Mark-Nielsen/2.-Semesters-projekt/README.md

# 2. Semesterprojekt

**Læs hele rapporten her:** [2. semesterprojekt rapport.pdf](<./2. semesterprojekt rapport.pdf>)
