Mark-Nielsen/2.-Semesters-projekt/Filer bruger under udvikling/1. Projekt/Bilag 1.A - Analyse.docx

# 1 Analyse

## 1.1 Hardware analyse

### 1.1.1 Infrarød sensor

Efter at have besluttet, at der i gruppen skulle bruges en infrarød sensor, blev der kigget efter hvilke sensorer der findes, og var mulige at få fat i. I denne forbindelse blev der kigget meget på hjemmesiden for elektronikværkstedet for at få inspiration. På vejen til det endelige valg af infrarød sensor, blev der forsøgt med forskellige slags.

Infrarød linetracker sensor KY-033

Den første infrarødsensor der blev brugt, var en Infrarød linetracker sensor KY-033, men efter nærmere undersøgelse i databladet blev der fundet ud af, at den ikke kunne opfylde de krav, der var til den infrarøde sensor, idet denne sensor kunne registrere hvorvidt den var på en specifik linje. Derfor var der nødvendighed for at fravælge denne sensor.

MH-SR602 PIR sensor

Dernæst blev infrarøde sensorer MH-SR602 PIR testet for anvendelse. De kunne registrere bevægelse og brugte infrarød stråling. Forståelse af hvordan sensoren virkede var, at den brugte infrarød stråling samt registrerede bevægelse til at detektere, hvorvidt en person var til stede i et givent rum. Dog efter at have testet disse med Arduino, blev det opdaget, at sensoren i stedet returnerede, hvorvidt der var bevægelse i et rum eller ej, og brugte den infrarøde stråling til at vurdere dette. Der blev derudover konkluderet, at den var meget upræcis i forhold til små ændringer i bevægelse, som den ikke kunne detektere, og dermed ville den ikke kunne detektere fx åndedræt fra patienter. Dermed opstod et problem, idet det var tiltænkt, at sensoren netop skulle kunne detektere ved brug af infrarød stråling om der var personer i et rum eller ej. Dog var sensoren nem at sætte op og bruge med en Arduino, og det blev hurtigt tydeliggjort, at den virkede som den skulle, dog ikke helt som ønsket i forhold til projektets mål. På trods af dette, var denne sensor stadig med i overvejelsen, idet der var 3 af disse sensorer til rådighed, hvilket ville betyde at der som ønsket kunne være en sensor i hver af de 3 rum, som brug til test af hvorvidt systemet virker.

Time of Flight VL53L0X sensor

Dernæst blev der undersøgt igen, hvilke infrarøde sensorer, der ville kunne bruges og efter samtale og vejledning fra en underviser fra projektfaget, blev der anbefalet at kigge på en Time of Flight sensor. Denne sensor brugte nemlig ikke meget strøm og brugte lysfotoner, som den udsendte i en lige linje, hvorefter tiden der gik fra at lysfotonerne blev udsendt og modtaget i sensoren igen, afgøre både afstand men også om der var et objekt.

Efter nærmere undersøgelse af hvordan disse virkede, blev der vurderet at det var et forsøg værd at teste denne Time of Flight sensor for at se, hvordan den virkede. Dog efter at kigge på elektronikværkstedets lager, var der ikke nok til at låne 3 stk. til systemet der skulle bygges. Dermed begyndte diskussionen på, hvorvidt der skulle købes nogle nye sensorer hjem, som desuden var af nyeste version og måske ville virke endnu bedre end dem fra elektronikværkstedet. Dog ville leveringen af disse tage tid, hvor der altså ikke kunne arbejdes på det, og da der begyndte at blive mindre og mindre tid tilbage, var der tvivl om denne sensor ville være det bedste valg.

Alligevel, valgtes at prøve at anvende en VL53L0X med en Arduino og bruge et stykke test-kode, fundet fra nettet. Resultat var ikke som forventet, idet at det så ud til at Arduinoen modtog signaler fra 2 forskellige sensorer på trods af, at der kun var koblet 1 sensor til. Der blev brugt en I2C protokol i denne test af sensoren, og der kunne ses på Arduino’en at de to adresser, den modtog signaler fra, ikke var fra adressen på den tilkoblede sensor. Dog var der også tydelige tegn på brug af sensoren, blev der antaget at den burde virke, men det virkede ikke til at være tilfældet. Derudover blev der fundet ud af, at denne sensor kun kan måle i én lige linje og vil derfor ikke kunne måle et helt rum. Dermed blev der overvejet at hvis sensoren virkede, så ville den blot blive placeret over fx sengene i hvert rum på et hospital, da det ville være her en patient kunne ligge i respirator og dermed ville blive opdaget af sensoren, i modsætning til en bevægelsessensor.

Efter at have brugt lang tid på at forsøge at få det til at virke med en Arduino, måtte denne løsning opgives, idet det blev for tidskrævende.

Overvejelser omkring MH-SR602 PIR sensor vs. Thermal camera vs. Tredje option

Inde på guiden som var tilgængelig på elektronikværkstedets webside, står der således omkring det termiske kamera i forhold til Arduino’en: ”If using an Arduino-compatible, you'll need a processor with at least 20KB RAM - a SAMD21 (M0) or SAMD51 (M4) chipset will do nicely”

Til forståelse af sensorens leveret output og outputtets form, bruges Gemini. Efter at have læst mere om sensorerne, vurderes det, at arbejdet med de termiske kameraer ville være en del tidskrævende, idet man skal sætte sig ind i både matriceregning og ADC og I2C kommunikation. Dog er I2C kommunikation brugbart og smart at bruge da man kan bruge forskellige enheder på samme tid og der skal desuden bruges færre ledninger.

Det termiske kamera er en løsning, der øger præcisionen af sensor løsningen. Dog kan det være svært at kode at den også skal tage højde for, at en person kan ligge under en dyne, da tanken umiddelbart var at den skulle kunne vurdere om der var en person til stede ud fra selvfølgelig temperaturen af pxiels’ene samt hvor mange pixels, der har denne temperatur - for at vise om det bare er et objekt eller en faktisk person. Derudover er databladet på 60 sider, hvor en stor del af det indeholder, hvad der ligner, komplicerede beregninger, som kræver en del tid at sætte sig ind i og forstå. Efter vejledning fra GAI (Gemini), kan der desuden konkluderes, at Arduinoen anvendt havde en clockfrekvens, der var for lav til at det ville give mening at bruge disse sensorer.

Hi-Link LD2450 Microwave Radar Module

Som en tredje mulighed kigges på Hi-Link LD2450 Microwave Radar Module, da denne bruger radar (doppler effekt) hvilket var mere præcist i forhold til PIR Sensor Module. Tanken var, at denne sensor muligvis kunne detektere så præcist at den kunne opfange et menneskes åndedræt. For at undersøge om denne sensor kunne bruges, blev der kigget på sensorernes datablad for at se dens egenskaber og begrænsninger, herunder fx max supply voltage. Derudover har der været forsøg på at opnå en forståelse for et stykke kode fra databladet, som kan bruges til denne sensor for at forstå, hvordan den virker. Ud fra dette blev der fundet ud af, at man kan indstille på nogle forskellige parametre, som er relevante for projektet, eksempelvis hvor hurtigt den kan detektere aktivitet i cm/s. Generelt, virker denne sensor til at være mere simpel at implementere. Denne sensor blev testet med Arduinoen og et stykke kode, for at se hvordan den reelt set virker og om den egentlig virker.

Der var en udfordring med at Arduino ikke modtog noget signal fra sensoren. Dette ledte til en større tidskrævende proces med debugging, hvor der blev testet både om sensoren overhovedet fik nok strøm hvortil der blev brugt et multimeter, og der blev testet om ledningerne virkede, da var nødvendighed for at gå med en mere hjemmelavet løsning, da Harwin husene ikke passede på de pins, der var på sensoren. der blev derudover også søgt om hjælp fra Gemini, som anbefalede at der blev brugt en spændingsdeler, som halvt blev forsøgte at forstå selv, og halvt blev forstået ved hjælp af elektronikværkstedet for at få vejledning.

Signalerne der kom ind, var hextal, og for denne specifikke sensor skulle det første sæt af hextal bestå af AA FF 03 00, hvorefter de efterfølgende hextal ville være output signalet fra sensoren. Dette var noget der kunne findes i databladet. Problemet var dog at man ikke kunne få denne sekvens af hextal frem på trods af mange timers debugging. Det tætteste man kunne komme frem til, var 00 FE 03 00. Efter at have fået hjælp og vejledning fra GAI samt eksperimenteret med ændring i testkode og opsætning af hardware, blev der konkluderet, at det var baudraten der var problemer med. Denne sensor havde nemlig en default baudrate på 256000, hvorimod Arduinoen stod på 9600 eller 115200. Der blev derfor forsøgt at øge baudraten på Arduinoen, hvilket gjorde at resultatet kom tættere på det rigtige sæt af hextal, dog var det ikke nok. Efter en omskrivning af koden, lykkedes det at omdanne disse hextal til mål af afstand i mm. Dog var målingerne meget ustabile og upræcise. Derfor blev der diskuteret hvorvidt målingerne var brugbare og om sensoren kunne bruges til projektet. Argumenter for at bruge sensoren var at den var mere kompleks og derfor måske mere spændende at arbejde med og samtidig var den stadig mere præcis end den oprindelige planlagte PIR sensorer, idet den kunne måle præcis afstand fremfor et output signal på HIGH eller LOW ved detekteret bevægelse. Dog var der som førnævnt problemer med baudraten. For at omgå dette problem blev løsningen at anvende en ESP32 frem for Arduino Mega2560. Denne løsning blev godkendt af projektets vejleder, Niels.

Ved nærmere undersøgelse af Hi-Link LD2450 Microwave Radar Module blev det klart, at denne type sensor ikke har en infrarød egenskab. Dette var uforeneligt med problemformuleringen, Use Cases, kravspecifikationen samt testspecifikationen, da det specificeres at infrarød stråling bruges til at detektere, hvorvidt en person er til stede i et lokale eller ej. Da denne sensor brugte radar, kunne den ikke anvendes uden større ændringer i projektet. Dette ledte tilbage til de termiske kameraer, som netop brugte infrarød stråling og samtidig var mere komplekse end de oprindelige PIR sensorer. Brugen af ESP32 microcontrolleren ville desuden gøre det muligt at bruge de termiske kameraer på grund af den højere clockfrekvens, og disse sensorer blev derfor mere relevante.

### 1.1.2 Microcontroller

Efter undersøgelse af ESP32 i forbindelse med valg af sensor kunne det konkluderes, at denne nye mikrocontroller i højere grad kunne bruges med teknisk krævende komponenter. ESP32 mikrocontrolleren har nemlig bl.a. en clockfrekvens på 240 MHz, hvorimod Arduinoen kun har 16 MHz, derud over en SRAM på 520 KB i sammenligning med Arduino Mega2560 8 KB SRAM.

Disse overlegne egenskaber gjorde ESP32 til en meget mere attraktiv mikrocontroller.

Ved test med ESP32 mikrocontrolleren, var der en række problemer med forbindelse til computer. For at løse dette problem blev GAI brugt til vejledning samt youtube videoer og google søgninger. Konklusionen blev at en manglede en speciel driver (CP210x USB to UART Bridge VCP driver) på computeren for, at den ville genkende mikrocontrolleren. Efter installering af denne, virkede forbindelsen mellem computeren og ESP32’eren uden problemer.

### 1.1.3 Strøm sensor

Arbejdet med power sensor (ASC712 5A) startede med realisationen om, at strømmen til 3 LED-set var alt for lav til, at strømsensoren kunne måle noget brugbart.
Støj på strømsensoren er, per databladet, 20 mV peak-to-peak, hvilket er omkring det samme udsving, der ville opstå ved den meget lave strøm. Løsningen på dette problem blev at øge strømmen til alle rum, og den bedste måde at opnå dette med en simpel løsning var at tilføje en modstand med lav modstandsværdi. Så strømmen til alle rum blev øget betydeligt. Da den effektive modstand over alle LED-set bliver så meget højere.

Effekten i disse modstande bliver naturligvis meget høj, og derfor skulle der bruges et par modstande, som kunne tåle høj effekt (omkring 1 W per Multisim). Der blev hentet et par modstande, der kunne tåle 2 watt, for at være på den sikre side.

Koden til strømsensoren er ekstrem simpel. Der læses bare en spænding på en ADC-pin på ESP’en. I starten blev der gemt noget data for at have en idé om, hvilken ADC-værdi der kom ud ved forskellige antal aktive ”rum” og dermed forskellige strømniveauer.

Dette data kan findes i bilag ”Data taget med Arduino Mega 2560 til Power Sensoren” & ”Data taget med ESP32 til Power Sensoren”.

Dette er brugt til at udarbejde en powerSensor-driver, som oversætter til et gæt på, hvor meget strøm der er blevet trukket over tid i mAh. Forklaring på denne databehandling findes i hovedrapporten. Undervejs blev analogRead skiftet ud med analogReadMilliVolts, da analogReadMilliVolts er kalibreret fra fabrikken og giver en mere præcis læsning af den reelle spænding sammenlignet med en rå ADC-læsning.

### 1.1.4 Valg af yderligere hardware komponenter

For at tage beslutningen om hvorvidt relæ eller transistor skulle anvendes, kigges på fordele og ulemper ved disse komponenter. Prototypen skal bruge hardware, som kunne fungere som en switch, der enten tænder eller slukker lyset. Da både et relæ og en transistor kan gøre dette, stod valget mellem en af disse komponenter.[^1]

#### 1.1.4.1 Relæ

Et relæ er en mekanisk komponent som fylder som regel mere end en transistor, hvilket kan være en ulempe, da der skal bruge 3 af dem - 1 til hvert sæt af LED’er. Dog kan relæet holde til en langt højere spænding end en transistor og kan styre en meget stor strøm, hvilket kan være mere fordelagtigt. En af de fordele, der var vigtigst var, at med et relæ ville der tages højde for galvanisk adskillelse, hvilket betyder, at relæet skaber adskillelse mellem de to spændingsforsyninger (ESP32 og nødgeneratoren i form af ekstern strømforsyning).[^2] På den måde skabes en sikkerhed i kredsløbet, da en eventuel fejl i transistoren ikke vil skade ESP32’en, men i stedet rammer relæet, som lettere og billigere kan erstattes.

#### 1.1.4.2 Transistor

En transistor har lidt flere funktioner end et relæ, idet en transistor ikke bare er en switch, der kan tænde og slukke lys, men den kan også regulere lysstyrken. Desuden sker skiftet hurtigere end på relæet.[^3] Med en transistor ville kredsløbet, der var mindre og mere simple, hvilket kan gøre hardwaren mere overskuelig generelt. En transistor har et lille spændingsfald over sig, hvilket svarer til typisk 0,7 V (base-emitter spændingsfaldet)[^4], hvilket betyder at når der bruges transistoren, opstår der et lille tab af energi. Ved brug af en transistor alene, vil det betyde, at en lille del af energien fra nødgeneratoren vil gå tabt. Dette kan dog undgås, hvis man også bruger et relæ, idet det i så fald vil gå ud over strømmen der leveres af ESP32 i stedet for strømmen fra nødgeneratoren.

Efter en vurdering af fordele og ulemper faldt valget på, at bruge både et relæ med en transistor. For at holde galvanisk adskillelse mellem ESP32 (PMS) og spændingsforsyning (Nødstrøm).

## 1.2 Software analyse

### 1.2.1 Valg af IDE

Denne IDE var især tiltalende, idet der i forvejen er inkluderet biblioteker såsom ”Arduino.h”, som ville gøre det nemmere at kode til hardwaren generelt. Derudover kunne man importere og installere andre offentlige biblioteker, som var tilpasset præcis den relevante mikrocontroller. Som en del af disse biblioteker var også en lang række eksempler på kode, der kunne bruges til forskellige applikationer til hardwaren.

[^1] ATO.com, (https://www.ato.com/difference-between-relays-and-transistors) ”Difference Between Relays and Transistors”
[^2] Stock, Michael, “Galvanic Isolation: Purpose and Methodologies”
[^3] ATO.com, ”Difference Between Relays and Transistors”
[^4] Bilag 1.F Datablade i ” Transistor BSX20 - 2864188”, side 2
