Mark-Nielsen/2.-Semesters-projekt/Filer bruger under udvikling/1. Projekt/Bilag 1.B - Arkitektur.docx

# 1 Systemarkitektur

## 1.1 Signalbeskrivelse til IBD

PMS | Signal-navn | Funktion | Område | Port 1 (Source) | Port 2 (Destination) | Kommentar
| In: VCC_5V: 5V | Leverer strøm gennem Raspberry Pi til hele PMS | 5V | Power Supply | Raspberry Pi
| In: Ground: 0V | Leverer ground gennem Raspberry Pi til hele PMS | 0V | Power Supply | Raspberry Pi
| In: touch: FORCE | User interagerer med touch-displayet | FORCE | User | Touch Display
| In: movement: MOVEMENT | Detekterer individer gennem IR Sensorer | MOVEMENT | Detecting Individuals | IR Sensor
| In: emergencyPowerIN: 15V | Strøm fra Emergency Power passerer igennem Power Sensor. | 15V | Emergency power | Power Sensor
| Out: emergencyPowerOUT: 15V | Strøm fra Emergency Power passerer igennem Power Sensor. | 15V | Power Sensor | Relaysystem
| Out: RelaySystem0 | Aktiver/Deaktiver Relaysystem 0 | 0-3.3V | ESP32: pin 17 | Relaysystem 0 (Transistor base) | Ikke inkluderet i tabel 15 i rapporten
| Out: RelaySystem1 | Aktiver/Deaktiver Relaysystem 1 | 0-3.3V | ESP32: pin 25 | Relaysystem 1 (Transistor base) | Ikke inkluderet i tabel 15 i rapporten
| Out: RelaySystem2 | Aktiver/Deaktiver Relaysystem 2 | 0-3.3V | ESP32: pin 26 | Relaysystem 2 (Transistor base) | Ikke inkluderet i tabel 15 i rapporten

Tabel 1 - Signalbeskrivelse for Power Management System i IBD

ESP32 | Signal-navn | Funktion | Område | Port 1 (Source) | Port 2 (Destination) | Kommentar
| In: VCC_ESP_5V: 5V | Forsyningsspænding for ESP32. | 5V | Raspberry Pi USB 3.0 | ESP32 mini USB
| In: Ground: 0V | Ground for ESP32. | 0V | Raspberry Pi USB 3.0 | ESP32 mini USB
| In: PWSOut: ≥2.5V | Signal fra Power Sensor. | ≥2.5V | Power Sensor | ESP32 | Power sensoren opererer på 5V logik mens ESP32 arbejder med 3.3V logik
| In: Connection: USB | Kommunikation imellem Raspberry Pi og Esp32. | | Raspberry Pi | ESP32
| Inout: G21: SDA | I²C signal fra multiplexeren | 3.3V | ESP32 pin G21 | Multiplexor SDA
| Out: G22: SCL | Clocksignal fra multiplexeren | 3.3V | ESP32 pin G22 | Multiplexor SCL
| Out: VCC_PS_5V: 5V | Forsyningsspænding til Power Sensor samt de 3 Relaysystems (0,1,2) | 5V | ESP32 | Power Sensor
| Out: VCC_M _3.3V: 3.3V | Forsyningsspænding til multiplexer | 3.3V | ESP32 | Multiplexer
| Out: RST | Reset signal til multiplexer | | ESP32 pin G4 | Multiplexer
| Out: G17 | Aktiver/Deaktiver Relaysystem 0 | 0-3.3V | ESP32 pin 17 | Relaysystem 0 (Transistor base) | ESP32 sender et LOW/HIGH signal til Relaysystem 0
| Out: G25 | Aktiver/Deaktiver Relaysystem 1 | 0-3.3V | ESP32 pin 25 | Relaysystem 1 (Transistor base) | ESP32 sender et LOW/HIGH signal til Relaysystem 1
| Out: G26 | Aktiver/Deaktiver Relaysystem 2 | 0-3.3V | ESP32 pin 26 | Relaysystem 2 (Transistor base) | ESP32 sender et LOW/HIGH signal til Relaysystem 2

Tabel 2 - Signalbeskrivelse for ESP32 i IBD

Raspberry Pi | Signal-navn | Funktion | Område | Port 1 (Source) | Port 2 (Destination) | Kommentar
| In: VCC_5V: 5V | Forsyningsspænding til Raspberry Pi | 5V | Battery | Raspberry Pi
| In: Ground: 0V | Ground til Raspberry Pi | 0V | Battery | Raspberry Pi
| Out: VCC_3.3V: 3.3V | Forsyningsspænding til Touch Display fra Raspberry Pi | 3.3V | Raspberry Pi | Touch Display
| Out: Display: MIPI DSI | Output fra Raspberry Pi til visuelt display på Touch Display | 8-18 bit | Raspberry Pi | Touch Display
| Out: Connection: USB | Kommunikation imellem Raspberry Pi og Esp32. | | Raspberry Pi | ESP32
| Out: VCC_ESP_5V: 5V | Forsyningsspænding til ESP32 | 5V | Raspberry Pi | ESP32

Tabel 3 - Signalbeskrivelse for Raspberry Pi i IBD

Touch Display | Signal-navn | Funktion | Område | Port 1 (Source) | Port 2 (Destination) | Kommentar
| In:Ground:0V | Ground til Touch Display | 0V | Raspberry Pi | Touch Display
| In: VCC_3.3V: 3.3V | Forsyningsspænding til Touch Display | 3.3V | Raspberry Pi | Touch Display
| In: Display: MIPI DSI | Forbindelse imellem Raspberry Pi og touch display | 8-18 bit | Touch Display | Raspberry Pi
| In: Touch: FORCE | Input til Touch Display fra User som trykker på displayet | High/low | User | Touch Display

Tabel 15: Signalbeskrivelse for Touch Display i IBD

Power Sensor | Signal-navn | Funktion | Område | Port 1 (Source) | Port 2 (Destination) | Kommentar
| In: VCC_PS_5V: 5V | Forsyningsspænding til Power Sensoren | 5V | Battery | Power Sensor
| In: Ground: 0V | Ground til Power Sensoren | 0V | Battery | Power Sensor
| In: emergencyPowerIN: 15V | Strøm fra Emergency Power passerer igennem Power Sensor. | 15V | Emergency Power | Power Sensor
| Out: emergencyPowerOUT: 15V | Strøm fra Emergency Power passerer igennem Power Sensor. | 15V | Power Sensor | Emergency Power
| Out: PWSOut: ≥2.5V | Output fra Power Sensor som angiver resterende strøm kapacitet af batteriet. | ≥2.5V | Power Sensor | ESP32

Tabel 4 - Signalbeskrivelse for Power Sensor i IBD

IR Sensor [1-3] | Signal-navn | Funktion | Område | Port 1 (Source) | Port 2 (Destination) | Kommentar
| In: VCC_IR_3.3V: 3.3V | Forsyningspænding for IR-Sensor | 5V | Raspberry Pi | IR-Sensor: Vcc
| In: Ground: 0V | Ground for IR-Sensor | 0V | Raspberry Pi | IR-Sensor: GND
| In: movement: MOVEMENT | Detekterer individer gennem IR Sensorer | MOVEMENT | Detecting Individuals | IR-Sensor
| In: SCL | Den “clock frequency” som bruges til kommunikation mellem multiplexer og IR sensor. | | Multiplexer: SC[0-2] | IR-Sensor: SCL
| Inout: SDA | Overførsel af målinger. | | Multiplexer: SD[0-2] | IR-Sensor: SDA | Serial Data der bruges til I²C kommunikation.

Tabel 5 - Signalbeskrivelse for IR-Sensor 1-3 i IBD

Multiplexer | Signal-navn | Funktion | Område | Port 1 (Source) | Port 2 (Destination) | Kommentar
| In: VCC_M_3.3V: 3.3V | Tilfører strøm til multiplexeren fra ESP32 | 3.3V | ESP32 | Multiplexer
| In: Ground: 0V | Ground for multiplexer | 0V | ESP32 | Multiplexer
| In: A0: 0V | A0 er med til at bestemme adressen på multiplexeren | 0V | ESP32 GND | Multiplexer
| In: A1: 0V | A1 er med til at bestemme adressen på multiplexeren | 0V | ESP32 GND | Multiplexer
| In: A2: 0V | A2 er med til at bestemme adressen på multiplexeren | 0V | ESP32 GND | Multiplexer
| In: SCL | Den “clock frequency” som bruges til kommunikation mellem ESP32 og multiplexer. | | ESP32 pin G22 | Multiplexer | Serial Clock
| In: RST | Forbindelsen til RESET gør at hvis der skulle opstå en fejl i I2C kommunikationen (eksempelvis hvis kommunikationen går i stå), så bliver denne kommunikation genstartet. | | ESP32 pin G4 | Multiplexer pin RST | RESET forbindelsen er ikke i brug, da vi, grundet tidspres, valgte ikke at implementere det. Da RESET bruger Active-LOW logik, har vi forbundet RESET til VCC på ESP32 gennem en pull-up modstand.
| Inout: SDA | Serial Data der bruges til I2C kommunikation. Overførsel af målinger fra IR sensorerne. | | ESP32 pin G21 / Multiplexer pin SDA | Multiplexer pin SDA / ESP32 pin G21 | Da det er en ikke-atomisk flowport, bliver det et inout signal, hvilket betyder, at data flyder i begge retninger. Derfor har vi noteret 2 sources (port 1) og 2 destinations (port 2)
| Inout: SD0 | Serial Data der bruges til I2C kommunikation mellem multiplexer og channel 0 | | Multiplexer pin SD0 / IR Sensor pin SDA | IR Sensor pin SDA / Multiplexer pin SD0
| Inout: SD1 | Bruges til I2C kommunikation mellem multiplexer og channel 1 | | Multiplexer pin SD1 / IR Sensor pin SDA | IR Sensor pin SDA / Multiplexer pin SD1
| Inout: SD2 | Bruges til I2C kommunikation mellem multiplexer og channel 2 | | Multiplexer pin SD2 / IR Sensor pin SDA | IR Sensor pin SDA / Multiplexer pin SD1
| Out: SC0 | Bestemmer serial clock (frekvens til kommunikation) mellem multiplexer channel 0 og IR sensor | | Multiplexer pin SC0 | IR Sensor pin SCL
| Out: SC1 | Bestemmer serial clock (frekvens til kommunikation) mellem multiplexer channel 1 og IR sensor | | Multiplexer pin SC1 | IR Sensor pin SCL
| Out: SC2 | Bestemmer serial clock (frekvens til kommunikation) mellem multiplexer channel 2 og IR sensor | | Multiplexer pin SC2 | IR Sensor pin SCL

Tabel 6 - Signalbeskrivelse for Multiplexer i IBD
