Mark-Nielsen/2.-Semesters-projekt/Filer bruger under udvikling/2. Proces/Bilag 2.E - Projekt idéer.docx

Ide 1

Projektkoncept: Fra regn til grøn energi

Et system til energiopsamling og overvågning i en regnvandskanal / spildvandsrør.

Konceptet
En vandturbine placeret i en stor regnvandskanal. Systemet skal ikke bare høste energi, men også fungere som en "vagt", der måler flow, så byen ikke oversvømmes.

Sensor 1 - Strømsensor – hvor meget strøm vi generer

Sensor 2 - Waterflowsensor – hvor meget spildevand der kommer gennem røret (Hall Effect Water Flow Sensor - 1-30 L/min, 1.75 MPa - YF-S201)

GUI - Parametre

Brugerinterface, hvor man kan regulere parametre såsom, hvor meget vand vi lader komme igennem til vores turbine / hvor meget strøm vi vil genere – så vi også kunne lukke helt af for vores turbine.

Ide 2

Projektkoncept: Energibesparende lys

Konceptet

Lyset tænder/slukker baseret på intensiteten af lys udenfor, og på om der er nogen i rummet. Systemet skal kunne tændes og slukket af brugeren om natten baseret på brugerens ønsker (i tidsrum, automatisk, eller ved on/off)

Sensor 1 - Lys sensor der måler lys intensitet udenfor.

Sensor 2 - Infrarød sensor

GUI - Parametre

Hvornår skal lyses slukkes?
(fx input fra brugeren: tidsinterval eller input fra brugeren: knap ON/OFF)

Spændende statistik. Gennemsnittelig lys over tid

Ide 3

Projektkoncept: Strømbesparings tilstand til bygninger i tilfælde af blackout.

Konceptet I tilfælde af at strømmen går, skal man kunne indstille hvilke ting der er “vigtigst” der får strøm (fra en generator)

Sensor 1 - Sensor der måler mængden af strøm tilbage

Sensor 2 - Infrarød sensor der kan måle livstegn i forskellige rum

GUI - Parametre

Prioritering af energi tildeling til bygningens strøm
