Mark-Nielsen/2.-Semesters-projekt/Filer bruger under udvikling/2. Proces/Bilag 2.D - Møder/Dagsordener/Dagsorden_11_03_261.docx

Mødested: 5123, lokale 214.

Dato: 04/03/26

Ordstyrer: Pernille

Referent: Aia

Dagsorden:

- Uddelegering af arbejdsbyrder
  - GUI
  - Strøm sensor
  - IR-sensor
