Mark-Nielsen/2.-Semesters-projekt/Filer bruger under udvikling/2. Proces/Bilag 2.D - Møder/Dagsordener/Dagsorden_18_02_26.docx

Dagsorden 18/02/2026

- Opfølging på review
- Tidsplan for projektet
- Bestil resterende komponenter til project

Infarød sensor, Sensor til at måle strøm, andre materialer
