Mark-Nielsen/2.-Semesters-projekt/Filer bruger under udvikling/2. Proces/Bilag 2.D - Møder/Dagsordener/Dagsorden_29_05_2026.docx

# Dagsorden til d. 29-04-26

1. Status på power sensor.
2. Status på infrarøde
