Mark-Nielsen/2.-Semesters-projekt/Filer bruger under udvikling/2. Proces/Bilag 2.D - Møder/Mødereferater/Mødereferat 04.03.26.docx

Dagsorden 04/03/2026

Mødested: 5123, lokale 214

Dato: 04/03/26

Ordstyrer: Mark

Referent: Pernille

Dagsorden:

- Use cases feedback (Niels)
  - Antal af use cases er fint
  - Gør ikke noget at vi ingen undtagelser/udvidelser har
    - Blot det er dækkende
- Accepttestspecifikation feedback (Niels)
  - Niels går det igennem og vender tilbage til os med godkendt/ikke-godkendt og eventuel feedback på både accepttestspecifikation og use cases.
  - Vi ved først ægte om vi er kommet hele vejen rundt, og om vi mangler noget når vi kommer til næste led
  - VIGTIGT vi får lavet en klar definition af SMS
  - Konkret feedback: 6.1
    - Det er lidt fluffy
    - Hvad skal vedligeholdes? Hvordan skal det vedligeholdes?
    - Konkretiser at det er en total inspektion af systemet og hvad denne inspektion indebærer
    - Eventuelt lav use casen om til boot-up inspektion og hvis denne bootup fejler, så skal aktøren vedligeholdelses firma komme/interagere med systemet
    - Evt i aktørbeskrivelsen skriv vores definition af hvad/hvem vedligeholdelses aktøren er
    - Ikke tænk i hvordan systemet integreres hos kunde, kun fokus på systemet i sig selv
    - Behøver ikke være “bulletproof”
    - Lav vedligeholdeses use case om til system-bootup
  - Konkret feedback 4.4
    - Er sletning af profiler også et krav? Yess
    - Specificer hvad vi mener med slots, er de faste, kan man slette, hvor mange nye kan man lave osv.

I dag eftersendes use case, diagrammer og accepttestspecifikation så niels kan kigge det igennem

Navn på hvem der har lavet hvad:
Accepttestspecifikation for både funktionelle (use-case) og ikke funktionelle krav

  - Use case 1: Initier SMS - David
  - Use case 2: Detekter aktivitet - Julie
  - Use case 3: Regulér strøm - Pernille
  - Use case 4: Indstil SMS - Jonas
  - Use case 5: Sluk SMS - Cecilie
  - Use case 6: Vedligeholdelse - Mark
  - Generelle krav - Pernille
- Hvordan kan vi måle hvor meget strøm der er tilbage i batteriet?
  - Kan ikke blive helt præcist - da det er super svært at lave
  - Evt have 2 der fokuserer på logistikken ved dette
    - Snak med folk i lab, de ved med stor sandsynlighed en del om det
  - Det er skoleprojekt så self bliver det ikke 1:1
- Skal vi have en separat accepttest for vores brugerinterface?
  - Ikke nødvendigt at binde os op på GUI endnu, bare fokus på hvad der er vigtigt for brugeren
  - Lige nu har vi kravene som “kunden” har, ingen grund til at teste præcise flow, eller binde os. GUI tets kan enden i alt for små detaljer, og lige nu er det overordnede vigtigt
- Hvordan skal vores BDD, IBD og domæneanalyse se ud / hvad skal inkluderes / hvad skal ikke?
  - Må ikke være for konkret fordi så fanges vi i det, og hvis de er for store, er de ubrugelige
  - Practical SysML (online lån) (https://www.sciencedirect.com/book/monograph/9780128002025/a-practical-guide-to-sysml)--> flere eksempler på BDD, IBD, domæneanalyse
  - Hensigtsmæssig nedbrydning i mindre dele
    - Prøv jer frem
  - Hvis uddybende forklaringer ikke passer ind i diagrammet, kan man lave en * med ekstra information
- Andet / evt.?
  - Review
    - Niels behøver ikke være med men vil gerne
      - Klar næste uge mandag kl 12
      - Kan næste uge tirsdag kl 14
      - Kan fredag efter kl 14, men vil ikke for langt hen på eftermiddagen
    - Review deadline er ikke hård, men god at følge - bliver ikke bonet for ikke at nå det
    - Intet skal afleveres
