Mark-Nielsen/2.-Semesters-projekt/Filer bruger under udvikling/2. Proces/Bilag 2.D - Møder/Mødereferater/Mødereferat 25.02.26.docx

Referat 25/02/2026

Fremmøde: Aia, Jonas, Pernille, David, Mark, Cecille, Julie.

Dato: 25/02/26

Ordstyrer: Julie.

Referent: Mark.

Dags orden:

- Gennemgang af tidsplan.
- Gennemgang af Niels review af problemformulering, samt titler.
- Gennemgang af use cases.
  - Kig use case diagrammer igennem, samt se forbindelser på diagrammer.
  - Antal use cases.
  - Krav om fail safe på sensorer, hvordan tester vi det?
  - Skal vi have en use case til vores brugeroverflade.
- Hører om hvordan review med andre grupper foregår.
- Skal vi have et systemcheck ved bootup.
- Spørg om Github er nødvendighed.

Referat:

Snakker om feedback på indledning. Herunder skal der være overskrifter på underpunkter.

Skal problemformulering være i toppen eller bunden? Niels forslår den skal være i toppen, da det skal være omfanget af vores opgave.

Problemformulering forklarer problemet. Der for giver den mening at have i toppen, før man går mere i dybten med projektet/løsning.

Problem først før løsning/svar.

Aia spørger ind til om vi skal have nævnt sensor i indledning.

Kan indgå i indledning, da vi har krav om hvilken komponenter der skal indgå i løsning. Derfor kan de være en central del af problemet. Selvom de endelig er en del af løsning, som eller bør komme længere nede.

Niels forslå at have grundlæggende sensor med, som valg af pc eller Raspberry pi.

Hvor mange use cases skal vi have med?

Niels siger vi skal finde et fornuftigt mængde use cases. Ikke hængte for meget op på antal.

Brug evt. MoSCoW til at bedømme, hvad der vigtigt at havde med.

Går igennem, og tag dem der er essentielle for vores system.

Niels kigger use case diagram.

Use syntes det er fint=))

Vi kigger på vores fully dressed use cases. Som tager udgangspunkt i vores use case diagram.

Vi kigger på use-case ”Init SMS”

Use-case fylder meget. Overvej at dele den op eller forkorte den en smule.

Flyt noget med indstilling og prioteringsliste, over til use-case ”indstil SMS”.

Niels siger der er kernen vil, af use-cases at finde ud af hvordan den skal opdeles.

Overvej, at bruge sekundær bruger i form af it-personale, der indstiller systemet. Og primære bruger er nødgenrator.

Vi kigger på use-cases ”Indstil sms”

Tilføj uddybelse på brugeren, fx brugeren(IT-personale), så det står helt klar, hvem brugeren er.

Kigger på use-case ”Detekter aktivtet”

Hold det fokuseret på essen af projektet. Ikke så meget fokus på at det kan fungere på et hospital.

Anbefal løs lille problem først. Snak om hvordan det teoretisk kunne skaleres i en virkelig situation til sidst.

Kigger på use-case ”tilslut strøm”

Skal vi lave en samlet afslut og tilslut strøm?

Niels siger: Overskuelighed er det vigtigeste. Risikere man at fare vild, hvis man skriver sammen? Hvis ja, så lav et. Hvis nej, så bare lav den samlet. Vi har plads nok, så skal ikke være for at spare en tabel.

Overordenet set for use-cases. Keep it simple. Pas på det ikke bliver for detaljeret. Kort og konkret er bedre.
