Mark-Nielsen/2.-Semesters-projekt/Filer bruger under udvikling/1. Projekt/Bilag 1.E - PowerSensor Data taget med ESP32 til Power Sensor kalibration.docx

# Session #2 med ESP32

3033 er baseline.

3040 er første gæt på 1 tændt rum.

1. 2.4% afvigelse med 124 afvigelser ved ADC < 3040 som vores gæt. Dette falder indenfor vores 3% afvigelses procent.
  a. Afvigelsen er beregnet som antal af målingerne der er højere end 3040 når ingen af rummene er tændt.
2. 1.88% afvigelse ved ADC <= 3040 og ADC => 3102 (For 1 rum)
  a. Afvigelsen er beregnet som antallet af målinger som ligger uden for spandet af [3035, 3102).
3. 2.8% afvigelse ved ADC <=3103 ADC =>3168 (For 2 rum)
  a. Afvigelsen er beregnet som antallet af målinger som ligger uden for spandet på [3168, 3103]
4. 2.7% ADC <= 3169 (For 3 rum)

Potentielle kilder til afvigelser: Temperatur varians i modstande.
