Mark-Nielsen/2.-Semesters-projekt/Filer bruger under udvikling/2. Proces/Bilag 2.F - TODO.docx

TODO

Imorgen:

- Popup funktioner udvid seriel_read()
- Skriv implementering færdig eller om
- GUI design skriv
- Processbeskrivelse

Skal gøres software:

- Profiler laves om til klasser
- Gui koblet til esp
  - Strømsensor data virker
  - Informationer fra profiler sendes til esp

Skal gøres rapport:

- Rettet diagrammer ud fra vores klasser
- Skriv process beskrivelse
- Skriv design process
  - Husk billeder af koden
  - Og beskriveslse af koden
- Skriv implementering
- Læs acceptest igennem for

Dokumenter:

- Software design (Rapport)
- Implementering (Rapport)
- Designprocess (Bilag)

Kan gøre nu:

- Password (Julie)
- Profilerne skal være seperate (Julie)
- Popups (Jonas) //DONE
- Lægge rum ind i tiers (Pernille)
- Infopage skrives (Pernille
- Linker active/inactive med active rooms (Jonas)
- Profiler gemmer først efter godkendt pin (Pernille/Julie)
- Tilføje colonne på profile_page med tiers (Jonas)
- Lav dropdowns om til indtastning (Julie)
- Lav popup ved return to idle (Jonas)
- Switch der slukker lyset/strømmet (Pernille)
  - Når switchen slås til igen returnerer “rummet” til den tidligere indstilling %
- Ikke-funktionel R4 – sluk efter brugerdefineret tid (Pernille)
- Grænse på brugerdefineret sluktid 5-600 sek

Gøres senere

- Link homepage med profiler
- Gem data til næste boot
- Link powerbar med strømsensor
- Ret infoside til
  - % er ved hvilken resterende % batteri strømmen skal gå 100% er bunden 0% er toppen
- Tilføj kode til alle profilerne
