Mark-Nielsen/2.-Semesters-projekt/Filer bruger under udvikling/1. Projekt/Bilag 1.G - Testmodul kode/read_serial_test_GUI/Uart.cpp

#include "uart.h"
#include <Arduino.h>

void uartInit(int baud_rate) {
    Serial.begin(baud_rate);
}

void uartSendString(const char *str) {
    Serial.println(str);
}

void uartSendInt(int val) {
    Serial.println(val);
}
