Mark-Nielsen/2.-Semesters-projekt/Filer bruger under udvikling/1. Projekt/Bilag 1.G - Testmodul kode/read_serial_test_GUI/switch.h

/************************************
* "Switch.h"                        *
* Header file for SWITCH driver.    *
* Version: MA                       *
************************************/
void initSwitchPort();
unsigned char switchStatus();
unsigned char switchOn(unsigned char switch_nr);
