Mark-Nielsen/2.-Semesters-projekt/Filer bruger under udvikling/1. Projekt/Bilag 1.G - Testmodul kode/send_serial_test_GUI/led.cpp

/****************************************
* "LED.C"                               *
* Implementation file for "LED driver"  *
* Version: MA                           *
****************************************/
#include <avr/io.h>
#define MAX_LED_NR 7

void initLEDport()
{
	DDRB = 0xFF;			//LED  porte er udgange
	PORTB = 0x00;		    //slukker LED'er
}

void writeAllLEDs(unsigned char pattern)
{
	// Hent parameteren og skriv til lysdioderne
	PORTB = pattern;
}

void turnOnLED(unsigned char led_nr)
{
	// Lokal variabel
	unsigned char mask;
	// Vi skal kun lave noget, hvis led_nr < 8
	if (led_nr <= MAX_LED_NR)
	{
		// Dan maske på basis af parameteren (led_nr)
		mask = 0b00000001 << led_nr;
		// Tænd den aktuelle lysdiode (de andre ændres ikke)
		PORTB &= ~mask;
	}
}

void turnOffLED(unsigned char led_nr)
{
	unsigned char mask;
	
	if (led_nr <= MAX_LED_NR)
	{
		// Dan maske på basis af parameteren (led_nr)
		mask = 0b00000001 << led_nr;
		// Sluk den aktuelle lysdiode (de andre ændres ikke)
		PORTB |= mask;
	}
}

void toggleLED(unsigned char led_nr)
{
	unsigned char mask;
	if (led_nr <= MAX_LED_NR)
	{
		// Dan maske på basis af parameteren (led_nr)
		mask = 0b00000001 << led_nr;
		// Toggle den aktuelle lysdiode (de andre ændres ikke)
		PORTB ^= mask;
	}
}
